brian-amos-embedded/woodworking/projects/pantry/output/part-STILE.png

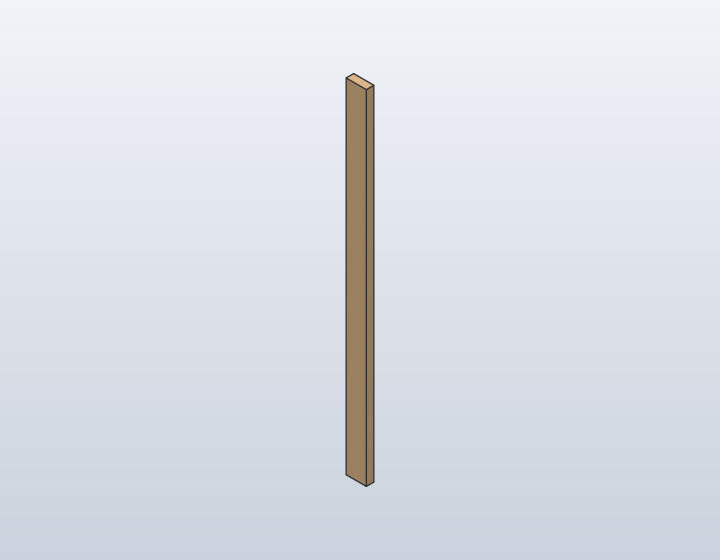
projects/pantry/output/part-STILE.png
