brian-amos-embedded/woodworking/projects/pantry/output/front.png

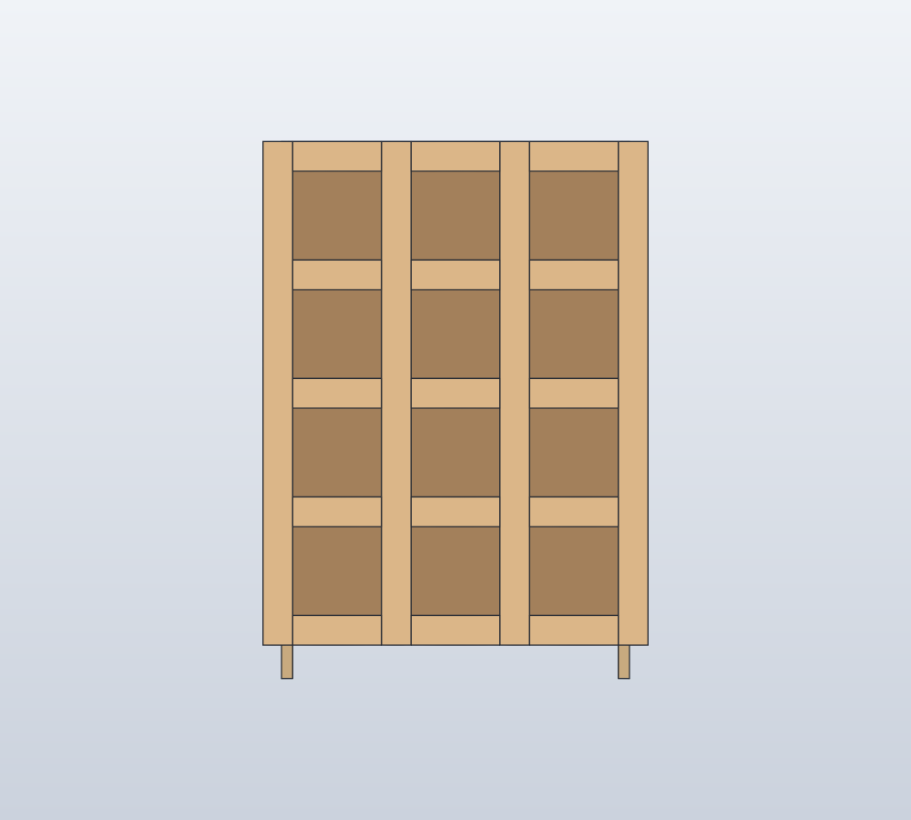
projects/pantry/output/front.png
