brian-amos-embedded/woodworking/projects/pantry/README.md

# Pantry assembly R6 and soda organizer R5

The two PDFs are separate shop packets. Open output/pantry-combined.sc for the
complete fit model, output/side-bays.sc for the side bays and countertop, or
output/soda-org-2.sc for the organizer machining model. The combined model
includes lighting clearance envelopes. Peg positions are field-drilling
annotations. Each side bay has one movable shelf shown at its upper sample position.

## Open a model in SolidCraft

Click a model to open an editable copy from the current `main` branch.

| Model | Open in browser | Native file |
| --- | --- | --- |
| Complete pantry assembly | [Open in SolidCraft](https://app.solidcraft.io/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) | [`pantry-combined.sc`](output/pantry-combined.sc) |
| Side shelves and countertop | [Open in SolidCraft](https://app.solidcraft.io/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) | [`side-bays.sc`](output/side-bays.sc) |
| Soda organizer | [Open in SolidCraft](https://app.solidcraft.io/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) | [`soda-org-2.sc`](output/soda-org-2.sc) |

[Side shelves shop pack](output/side-shelves-shop-pack.pdf) ·
[Soda organizer shop pack](output/soda-organizer-R5-shop-pack.pdf)

## Rebuild

From the repository root, with Python 3.12+, ReportLab, and SolidCraft 0.40.1:

```sh
python skills/woodworking-solidcraft/scripts/build_project.py projects/pantry --cli /absolute/path/to/solidcraft-cli
```

`project.json` defines the organizer wood parts. The organizer assembly in
`source/` adds the lighting channels and is included by the combined model. Keep the
organizer and side-bay interface dimensions aligned when revising the design. `overrides.json` selects models, test dimensions,
and the shop-pack template, and can override any setting in
[projects/defaults.json](../defaults.json).

The shop packs use nominal stock. Field-fit the side shelves and countertop.
Verify the pins and extrusion end caps, wiring and clips before machining.

The soda organizer has continuous angled channels behind rows 3, 4 and 5 and a rectangular channel behind row 2. Rows count from the bottom, and the lowest base rail is row 1. The side-bay channels mount to the rear faces of the countertop rails and middle shelf aprons.

The countertop projects 1 inch in front of the rails and stiles.

Each side bay has a scribed fixed bottom shelf with a rear-rabbeted front rail, aligned with the organizer's lowest rail.

Movable shelf aprons align with the face frame. The plywood wraps behind the stiles with front corner reliefs. The SolidCraft files use part components and share definitions for explicitly matched repeats.
