brian-amos-embedded/woodworking/projects/pantry/output/soda-organizer-R5-shop-pack.pdf

# Soda organizer 2

Cut list and table-saw plan | 26 W x 18 1/8 D x 36 1/4 H in

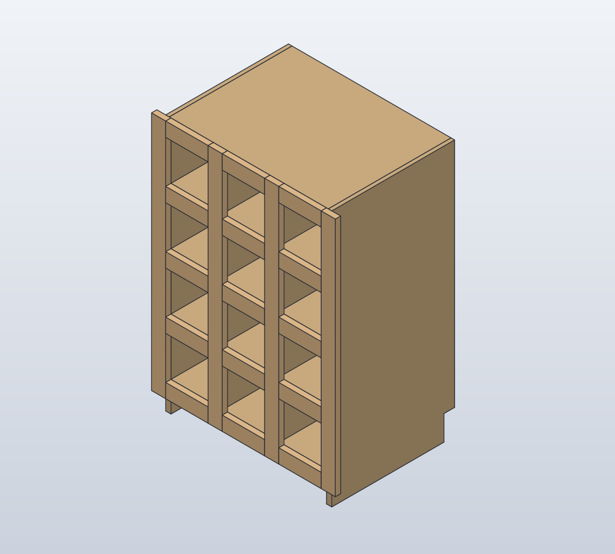
[picture p6: figure]

SODA ORGANIZER 2 / R5 / NOMINAL-STOCK DRAFT | 1

### Stock for this layout

3/4 in maple plywood
1 full 48 x 96 in sheet
+ 1 offcut, 16 x 36 in

1/4 in maple plywood
1 offcut, 24 x 36 in

4/4 hard maple
3.62 board ft in rough blanks Before defect and yield loss

## Plywood blanks

Part | Qty | Along grain x across grain x thickness (in)
Sides | 2 | 36 1/4 x 17 3/8 x 3/4
Dividers | 2 | 31 3/4 x 16 5/8 x 3/4
Top and bottom | 2 | 22 1/2 x 17 3/8 x 3/4
Outer-bay shelves | 6 | 16 5/8 x 7 1/8 x 3/4
Center-bay shelves | 3 | 16 5/8 x 7 3/4 x 3/4
Back | 1 | 31 11/16 x 22 7/16 x 1/4

Measure stock before machining

The drawings use 0.750 in carcass stock and 0.250 in back stock.
Test-fit scrap in the dados and grooves. Regenerate if measured thickness changes.

The grain direction is marked on each sheet. A second full 3/4 in sheet can supply S2.

# S1 | 3/4 in maple plywood

48 x 96 in stock | Grain along 96 in
SODA ORGANIZER 2 / R5 / NOMINAL-STOCK DRAFT | 2

Trim 1/4 in per edge. Keep the 1/8 in kerf on the waste side.
Rip the strips at the widths shown, then crosscut along each strip as drawn.
SIDE-L | SIDE-R | TOP
DIV-1 | DIV-2 | BOT
SH-C1 | SH-C2 | SH-C3 | SH-L1 | SH-R1

### 96 in

### 48 in

GRAIN / LONG DIMENSION

17 3/8

17 3/8

7 3/4

Rip width | Kept pieces | Final width x length (in)
17 3/8 | SIDE-L, SIDE-R | 17 3/8 x 36 1/4
| TOP | 17 3/8 x 22 1/2
17 3/8 | DIV-1, DIV-2 | 16 5/8 x 31 3/4
| BOT | 17 3/8 x 22 1/2
7 3/4 | SH-C1, SH-C2, SH-C3 | 7 3/4 x 16 5/8
| SH-L1, SH-R1 | 7 1/8 x 16 5/8

If final width is smaller than the rip width, crosscut the blank first, then narrow it.

# S2 | 3/4 in maple plywood

16 x 36 in stock | Grain along 36 in
SODA ORGANIZER 2 / R5 / NOMINAL-STOCK DRAFT | 3

Trim 1/4 in per edge. Keep the 1/8 in kerf on the waste side.
Rip the strips at the widths shown, then crosscut along each strip as drawn.
SH-R2 | SH-R3
SH-L2 | SH-L3

### 36 in

### 16 in

GRAIN / LONG DIMENSION

7 1/8

7 1/8

Rip width | Kept pieces | Final width x length (in)
7 1/8 | SH-L2, SH-L3 | 7 1/8 x 16 5/8
7 1/8 | SH-R2, SH-R3 | 7 1/8 x 16 5/8

If final width is smaller than the rip width, crosscut the blank first, then narrow it.

# S3 | 1/4 in maple plywood

24 x 36 in stock | Grain along 36 in
SODA ORGANIZER 2 / R5 / NOMINAL-STOCK DRAFT | 4

Trim 1/4 in per edge. Keep the 1/8 in kerf on the waste side.
Rip the strips at the widths shown, then crosscut along each strip as drawn.

BACK

### 36 in

### 24 in

GRAIN / LONG DIMENSION

22 7/16

Rip width | Kept pieces | Final width x length (in)
22 7/16 | BACK | 22 7/16 x 31 11/16

If final width is smaller than the rip width, crosscut the blank first, then narrow it.

# Hard maple and joinery

4/4 rough stock | Mill to 3/4 in finished thickness
SODA ORGANIZER 2 / R5 / NOMINAL-STOCK DRAFT | 5
Part | Qty | Finished L x W (in) | Rough L x W (in)
Stile | 4 | 34 x 2 | 35 x 2 1/8
Rail | 15 | 6 x 2 | 7 x 2 1/8

3.62 board ft of rough blanks at 1 in nominal thickness. Board yield depends on your stock.

See the next page for the default board layout. Use the HTML planner for measured stock. Face frame uses glued, pocket-screwed butt joints. Check screw placement on scrap.

## Joinery drawings

See the following pages for machining faces, edge references and cut depths. Dry-fit the shelf-and-divider core on the bottom, seat the back, then fit the top. Bring in the outer sides and check square before fitting the face frame.

# 4/4 hardwood cut plan

Hard maple | 2 boards at 6 x 96 in usable
SODA ORGANIZER 2 / R5 / NOMINAL-STOCK DRAFT | 6

Kerf: 1/8 in. Square one end and straighten one edge before measuring usable stock. Rip the strips first, then crosscut left to right. Dimensions shown are rough blanks.

### Board B1

ST-3 | ST-4 | RA-21 | RA-22 | RA-23
ST-1 | ST-2 | RA-11 | RA-12 | RA-13
Strip 1 | Rip 2 1/8 in | ST-1 / ST-2 / RA-11 / RA-12 / RA-13 Crosscut lengths (in) 35 + 35 + 7 + 7 + 7
Strip 2 | Rip 2 1/8 in | ST-3 / ST-4 / RA-21 / RA-22 / RA-23 Crosscut lengths (in) 35 + 35 + 7 + 7 + 7

### Board B2

RA-31 | RA-32 | RA-33 | RA-41 | RA-42 | RA-43 | RA-51 | RA-52 | RA-53
Strip 1 | Rip 2 1/8 in | RA-31 / RA-32 / RA-33 / RA-41 / RA-42 / RA-43 / RA-51 / RA-52 / RA-53
Crosscut lengths (in) 7 + 7 + 7 + 7 + 7 + 7 + 7 + 7 + 7

# Joinery | SIDE-L

Sides / Qty 1 each hand / 3/4 in maple plywood

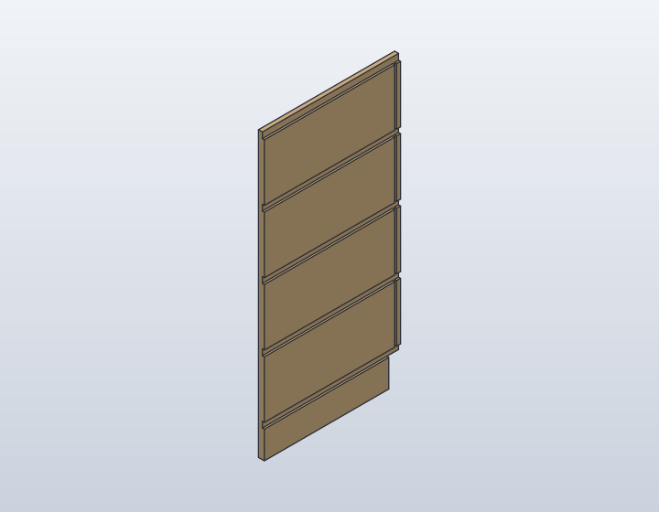
[picture p7: figure]

SODA ORGANIZER 2 / R5 / NOMINAL-STOCK DRAFT | 7

17 3/8 x 36 1/4 in

0 / BOTTOM

3 1/2

11 1/2

19 1/2

27 1/2

35 1/2

INSIDE FACE

16 5/8 from front to groove

FRONT

Shelf dados: 3/4 in wide x 1/4 in deep.

Back groove: 1/4 in wide x 1/4 in deep.

Run the dados and back groove through.

Rear-bottom relief: 1 1/2 in x 3 1/2 in, through.

Bottom is the common datum for all five shelf dado starts.

# Joinery | SIDE-R

Sides / Qty 1 each hand / 3/4 in maple plywood

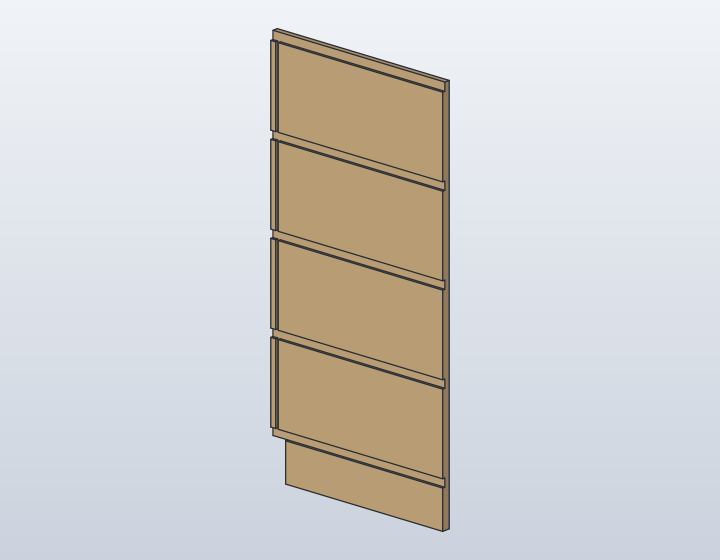
[picture p8: figure]

SODA ORGANIZER 2 / R5 / NOMINAL-STOCK DRAFT | 8

17 3/8 x 36 1/4 in

0 / BOTTOM

3 1/2

11 1/2

19 1/2

27 1/2

35 1/2

INSIDE FACE

16 5/8 from front to groove

FRONT

Shelf dados: 3/4 in wide x 1/4 in deep.

Back groove: 1/4 in wide x 1/4 in deep.

Run the dados and back groove through.

Rear-bottom relief: 1 1/2 in x 3 1/2 in, through.

Bottom is the common datum for all five shelf dado starts.

# Joinery | DIV-1 and DIV-2

Dividers / Qty 2 / 3/4 in maple plywood

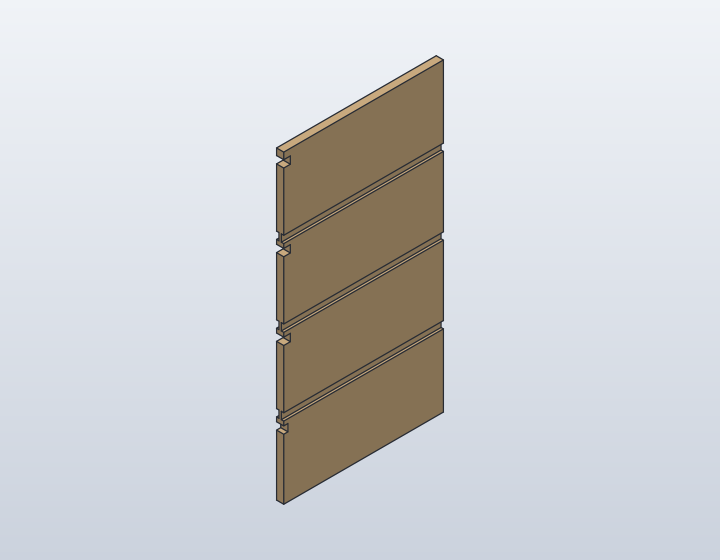
[picture p9: figure]

SODA ORGANIZER 2 / R5 / NOMINAL-STOCK DRAFT | 9

16 5/8 x 31 3/4 in

0 / BOTTOM

7 1/2

15 1/2

23 1/2

BOTH FACES

Dados: 3/4 in wide x 1/4 in deep.

Run through from front to rear.

Repeat the pattern on the opposite face.

Opposing dados leave a 1/4 in web.

Channel reliefs: 3/4 in high, through thickness. Depth from front: 7/16 in lowest, 11/16 in others.

Lower edges from divider bottom (in):
6 5/16, 14 5/16, 22 5/16, 30 5/16

# Joinery | TOP and BOT

Top and bottom / Qty 2 / 3/4 in maple plywood

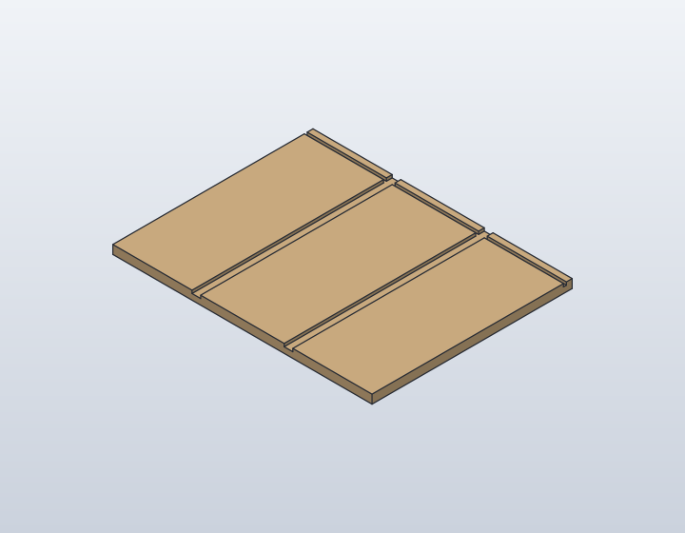
[picture p10: figure]

SODA ORGANIZER 2 / R5 / NOMINAL-STOCK DRAFT | 10

22 1/2 x 17 3/8 in
6 7/8 from left

14 7/8 from left

LEFT / FRONT DATUM

16 5/8
from front

Divider dados: 3/4 in wide x 1/4 in deep. Run front to rear.

Back groove: 1/4 in wide x 1/4 in deep. Run left to right.

Machine the top underside and the bottom upper face with this same pattern.

# Joinery | Shelves and back

Maple plywood / Square edges seat in the carcass recesses

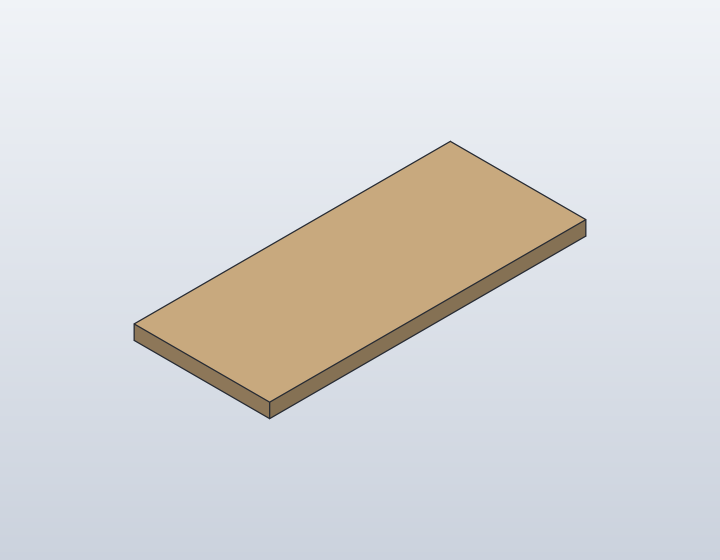
[picture p11: figure]
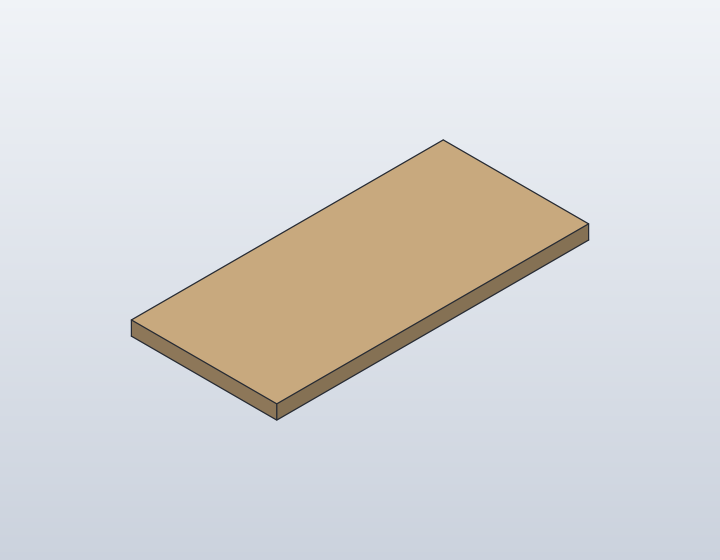
[picture p12: figure]
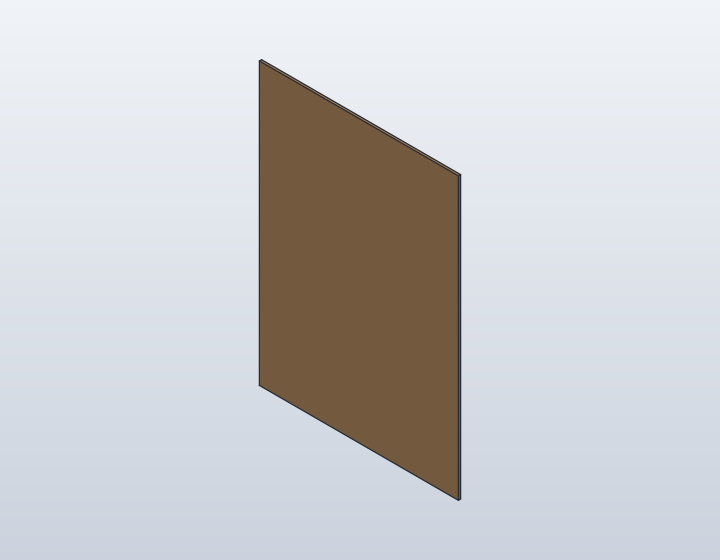
[picture p13: figure]

SODA ORGANIZER 2 / R5 / NOMINAL-STOCK DRAFT | 11

Outer-bay shelves / SH-L1 to L3 and SH-R1 to R3 / Qty 6

16 5/8 x 7 1/8 in

3/4 in thick

Center-bay shelves / SH-C1 to C3 / Qty 3

16 5/8 x 7 3/4 in

3/4 in thick

Back / BACK / Qty 1

22 7/16 x 31 11/16 in

1/4 in thick

# Joinery | Hardwood face frame

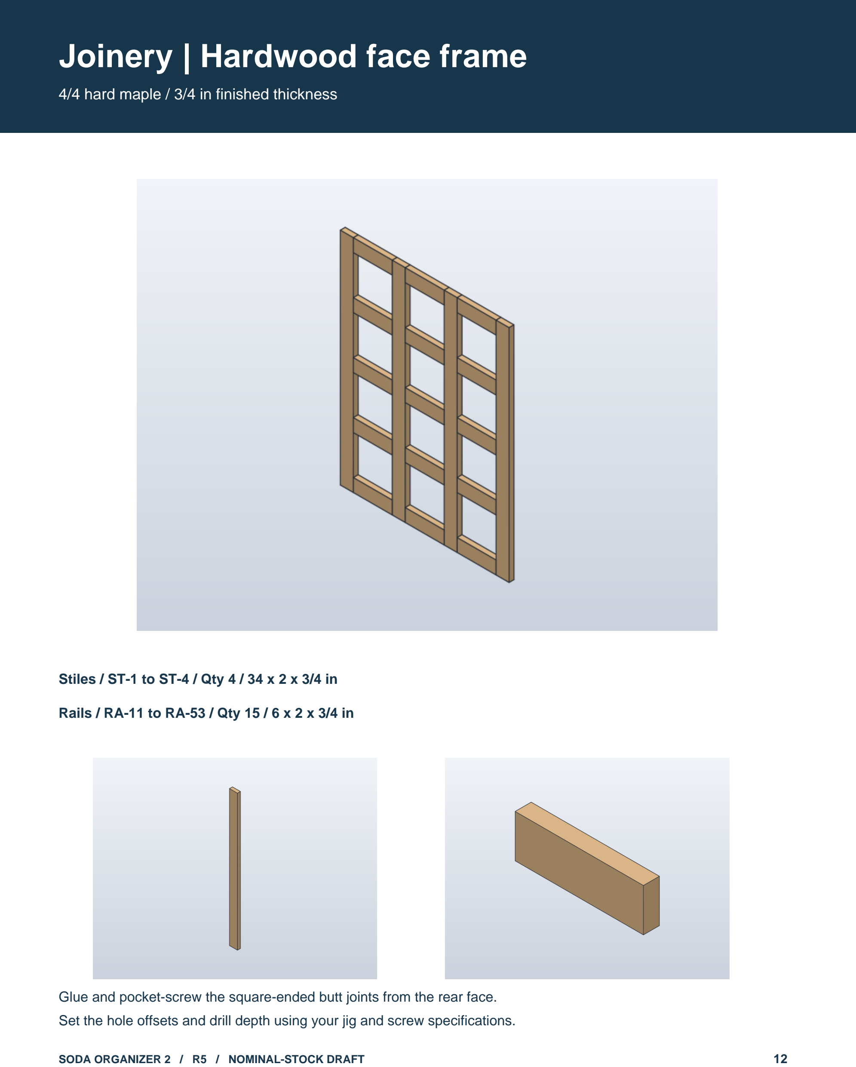
[picture p14: page 12]

4/4 hard maple / 3/4 in finished thickness

SODA ORGANIZER 2 / R5 / NOMINAL-STOCK DRAFT | 12

Stiles / ST-1 to ST-4 / Qty 4 / 34 x 2 x 3/4 in

Rails / RA-11 to RA-53 / Qty 15 / 6 x 2 x 3/4 in

Glue and pocket-screw the square-ended butt joints from the rear face.
Set the hole offsets and drill depth using your jig and screw specifications.

# Soda organizer lighting

R5 | Four rear-mounted continuous channels
SODA ORGANIZER 2 / R5 / NOMINAL-STOCK DRAFT | 13

Cut three 21 3/4 in angled runs (65 1/4 in total) from the 72 in stock. Mount angled runs behind rows 3, 4 and 5, counted from the bottom. Cut one 21 3/4 in rectangular run for row 2, with its light facing the back. Each run spans all three columns. Mount 1/8 in above the rail lower edge.

Cut four front-edge reliefs through each inner divider.

Test the 11/16 in angled and 7/16 in rectangular relief depths with actual profiles. Feed each row from the side or rear with accessible connections.

### Outside-face shelf pins

Transfer the shared level datum from the side bays. Use two rows per organizer side. Check 1/8 in pins and insertion depth against the actual hardware.
At dado and groove crossings, nominal wall thickness remaining is 1/2 in.
See the side-bay packet for provisional pin locations and drilling limits.
