brian-amos-embedded/woodworking/skills/sketchup-extract/references/migration.md

# Soda org 2 source and extraction

Original pantry.skp is preserved as Library file libfile_5a88f77dd8388191b17ddc1ebeb677a3. SHA256: 19a2387586fe015a8f0bcb97b58c5019b88b0625cddc050c066fdf67783959e9. Header: 27.0.0. Prefer a newer source if supplied.

Direct Python extraction with skppy 0.10.0 succeeded. Exact target soda org 2 has 35 immediate instances, no immediate groups, and eight geometry definitions: soda shelf center 3, soda side 2, soda rail 15, soda shelf 6, soda stile 4, soda side#1 2, soda top bot 2, soda back 1. Reachable graph includes the root assembly as a ninth definition. Face loops and vertices were extracted and structurally validated; SolidCraft conversion and fabrication accuracy are still pending.

Brian cannot install SketchUp Desktop. Use direct Python as the default and only bundled extraction path. Brian intends SolidCraft to be authoritative, with SketchUp only for rough drafting/reference. Do not build round-trip editing or make desktop software a prerequisite.

The completed initial extraction is saved as soda-org-2.json, Library file libfile_75c49fa9bf908191b594383183eba958. It contains schema v2 geometry and placement data; retrieve the current saved version when resuming.
