brian-amos-embedded/woodworking/projects/pantry/output/back.png

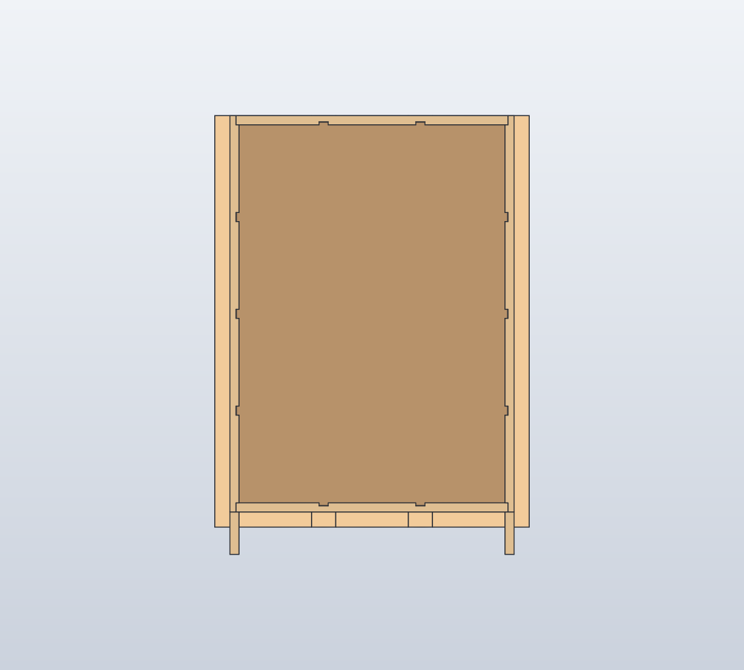
projects/pantry/output/back.png
