brian-amos-embedded/woodworking/projects/pantry/output/part-RAIL.png

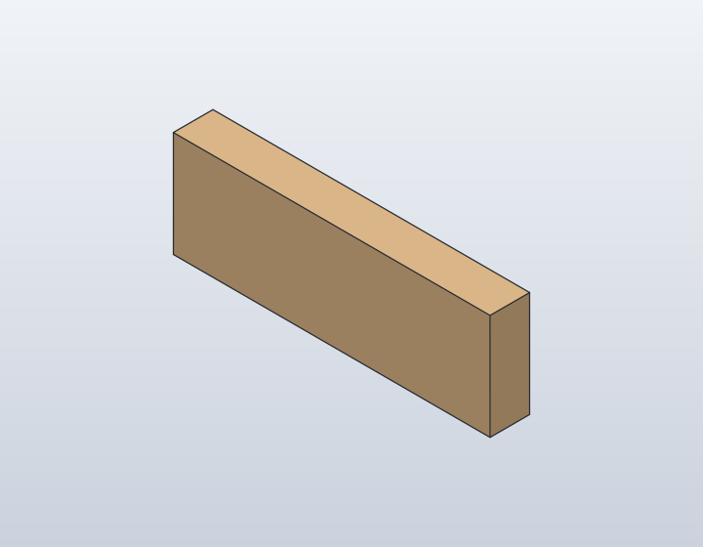
projects/pantry/output/part-RAIL.png
