brian-amos-embedded/woodworking/projects/pantry/output/side-bays.png

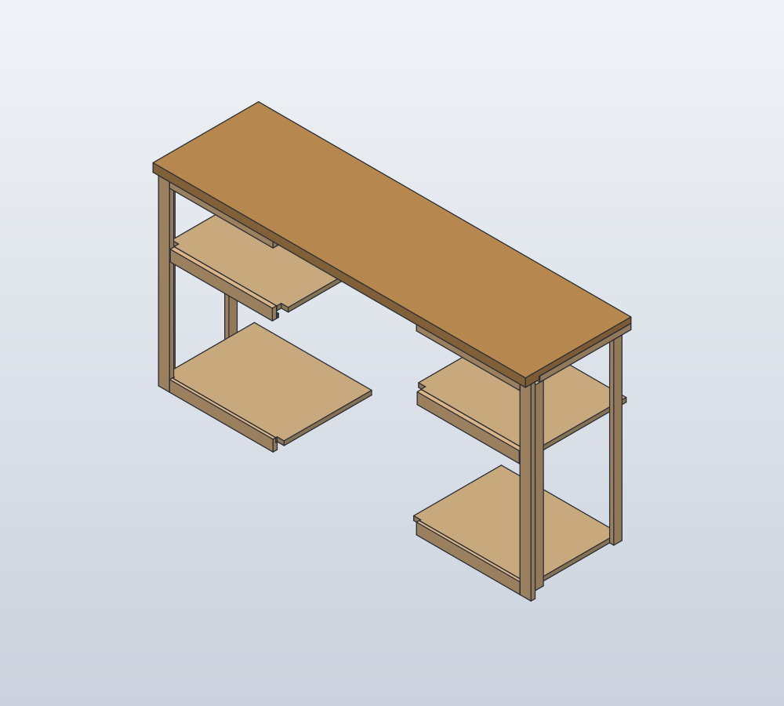
projects/pantry/output/side-bays.png
