brian-amos-embedded/woodworking/skills/woodworking-solidcraft/assets/trial/soda-org-2-thumbnail.jpg

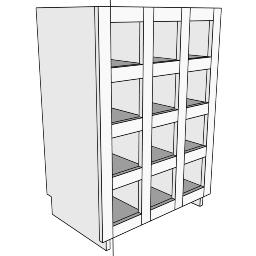
skills/woodworking-solidcraft/assets/trial/soda-org-2-thumbnail.jpg
