brian-amos-embedded/woodworking/projects/pantry/output/soda-org-2.step

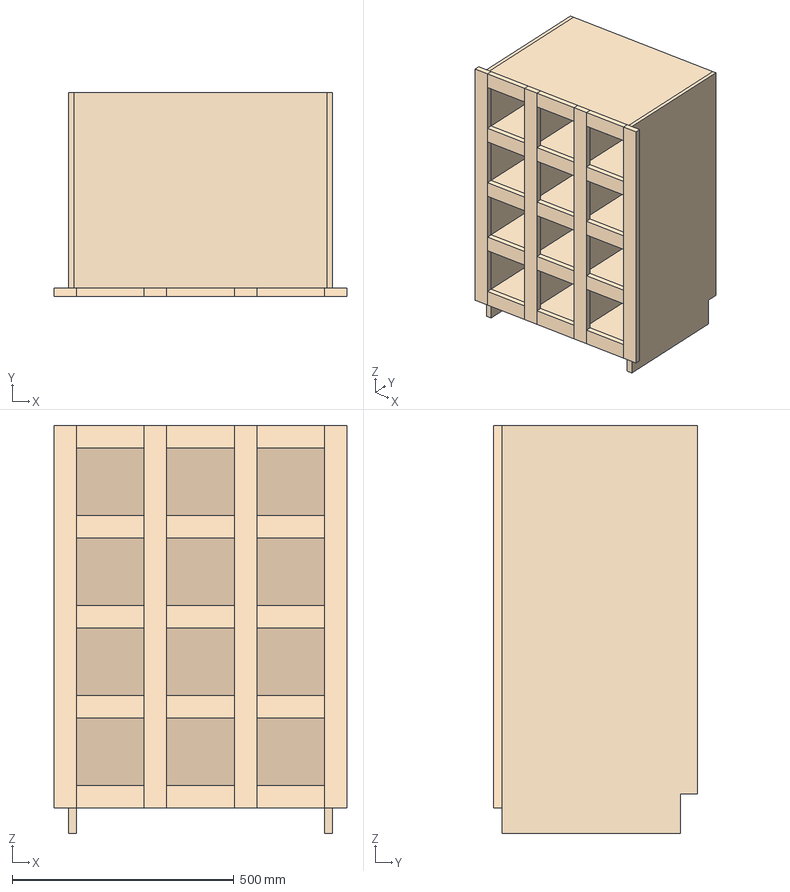
[picture p21: CAD file, 2026-11-13]
projects/pantry/output/soda-org-2.step
660.4 x 460.4 x 920.8 mm
LED-SODA-2
LED-SODA-3
LED-SODA-4
LED-SODA-5
SIDE-L
SIDE-R
DIV-1
DIV-2
BOT
TOP
SH-L1
SH-C1
SH-R1
SH-L2
SH-C2
SH-R2
SH-L3
SH-C3
SH-R3
BACK
ST-1
ST-2
ST-3
ST-4
RA-11
RA-12
RA-13
RA-21 x 3
RA-22 x 3
RA-23 x 3
RA-51
RA-52
RA-53
