brian-amos-embedded/woodworking/(commit log)

2026-11-13 Add pantry project and reusable woodworking tooling
    [cut-sequence.csv, hardwood-cut-list.csv, machining.csv, plywood-cut-list.csv, soda-org-2.step]
2026-11-13 Organize projects and document ChatGPT onboarding
    [cut-sequence.csv, hardwood-cut-list.csv, machining.csv, plywood-cut-list.csv, soda-org-2.step]
2026-11-13 Update pantry lighting, shelf support and countertop overhang
    [machining.csv, soda-org-2.step]
2026-11-13 Mount rectangular pantry LEDs to rear rail faces
2026-11-13 Align movable shelf fronts and build native SolidCraft components
    [soda-org-2.step]
2026-11-13 Use one movable shelf per bay and show both soda LED runs
    [soda-org-2.step]
2026-11-13 Light all four soda organizer shelf rails
    [machining.csv, soda-org-2.step]
2026-11-13 Include illustrated hardwood cut plans in both pantry shop packs
